nithin-uppalapati/pathExplorer/README.md

# pathExplorer
IOT Course Project

1. Go to src directory and find the code for the desktop app built in Python - using kivy library. 
2. Also find the sketch used for Arduino.
   - The MPU6050 library used in main.ino can be found here: https://github.com/jarzebski/Arduino-MPU6050/archive/master.zip

--------------------------------------------------------------------------------------------------------------------------

Link to Project Presentation Video:

https://youtu.be/aE0qC3Gd6RY

--------------------------------------------------------------------------------------------------------------------------
More VIDEOS available in YouTube Playlist, please check them.
Link to Youtube Playlist - 

https://youtube.com/playlist?list=PL-M9s4MhWbnSIu-q1vE16PTl7EcQsCjpp

--------------------------------------------------------------------------------------------------------------------------

Schematic:
