nithin-uppalapati/pathExplorer/iot_proj_schematic_pdf.pdf

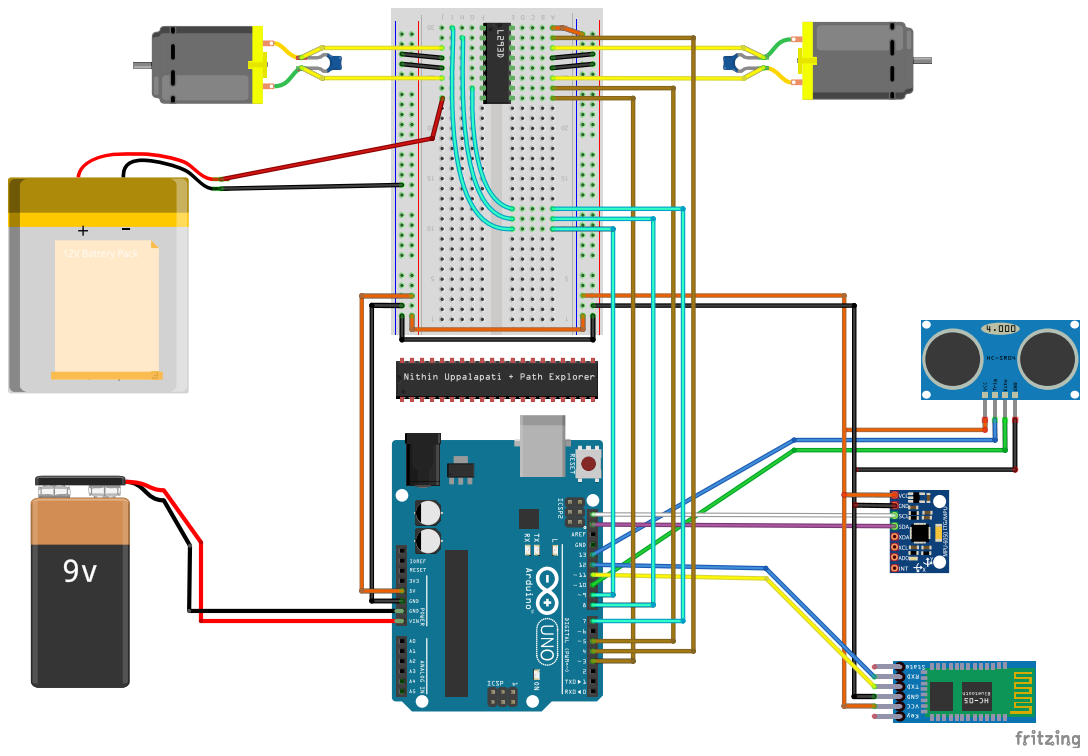
[picture p15: page 1]
12V Battery Pack
